bam-project/esp32-sobel-camera/cad/portable-camera.FCStd

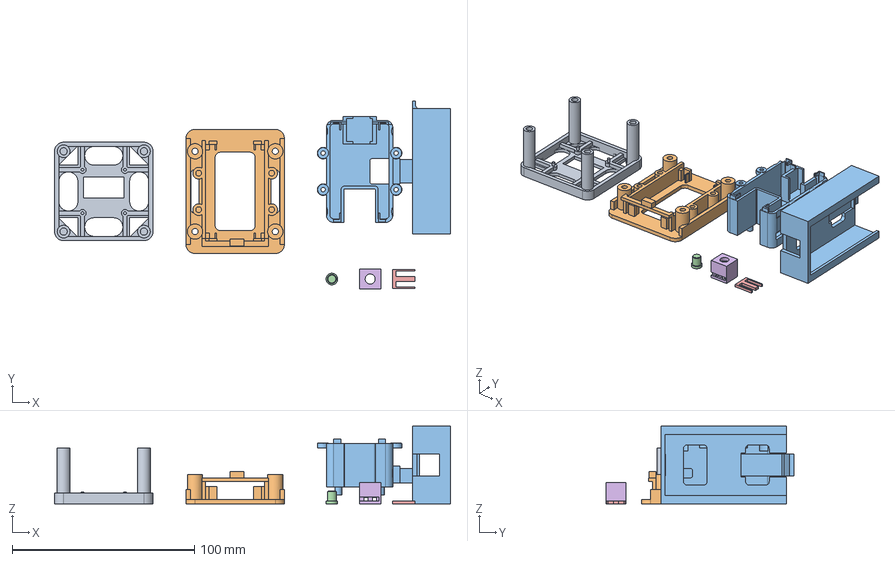
[picture p5: CAD file, 2026-10-13]
cad/portable-camera.FCStd
217.0 x 102.9 x 42.6 mm
01 — Screen body
02 — Camera base
03 — Cable cover
04 — Shutter press cap
06 - Sliding shutter backing key
05 - Removable shutter tray
