bam-project/esp32-sobel-camera/printing/parts/04-shutter-cap.3mf

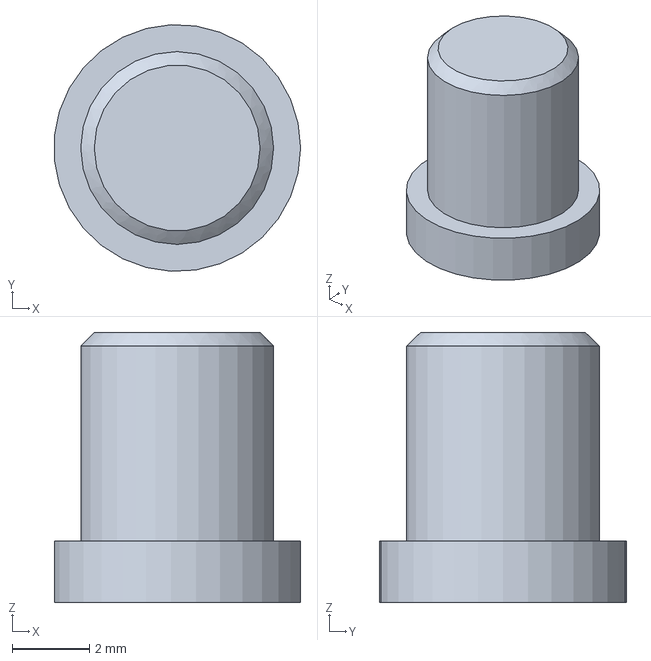
[picture p6: CAD file, 2026-10-13]
printing/parts/04-shutter-cap.3mf
6.38 x 6.39 x 7.00 mm
