bam-project/esp32-sobel-camera/printing/parts/02-camera-base.3mf

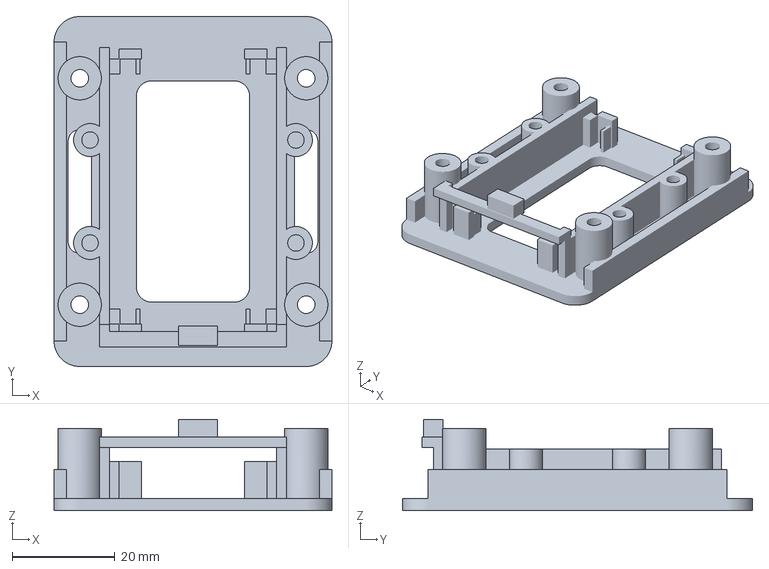
[picture p7: CAD file, 2026-10-13]
printing/parts/02-camera-base.3mf
54.0 x 68.0 x 17.8 mm
