bam-project/esp32-sobel-camera/printing/parts/01-screen-body.3mf

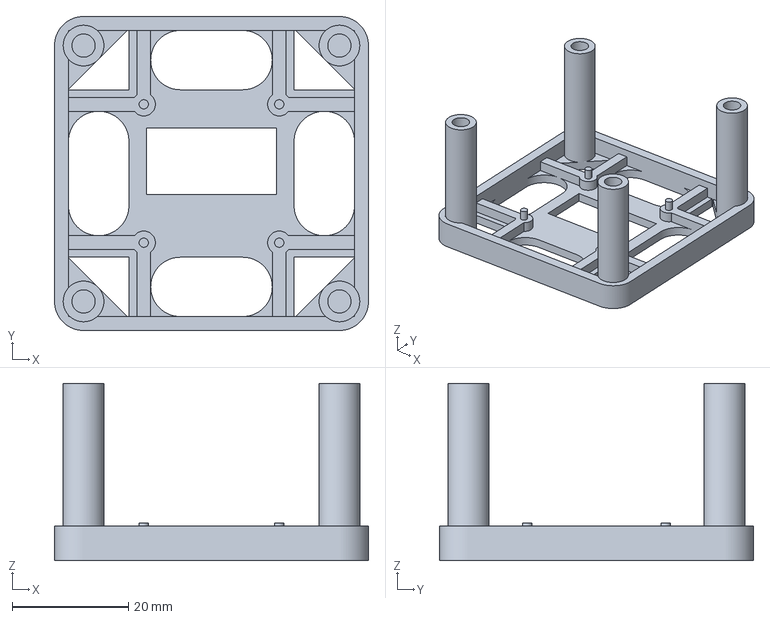
[picture p8: CAD file, 2026-10-13]
printing/parts/01-screen-body.3mf
54.0 x 54.0 x 30.5 mm
