bam-project/esp32-sobel-camera/printing/parts/05-shutter-tray.3mf

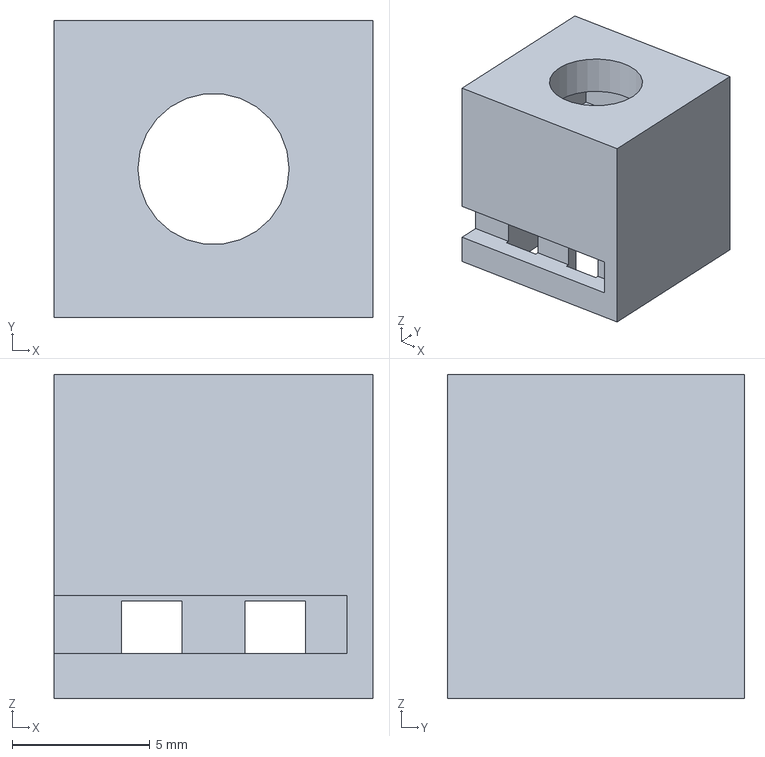
[picture p9: CAD file, 2026-10-13]
printing/parts/05-shutter-tray.3mf
11.6 x 10.8 x 11.8 mm
