bam-project/esp32-sobel-camera/printing/parts/03-cable-cover.3mf

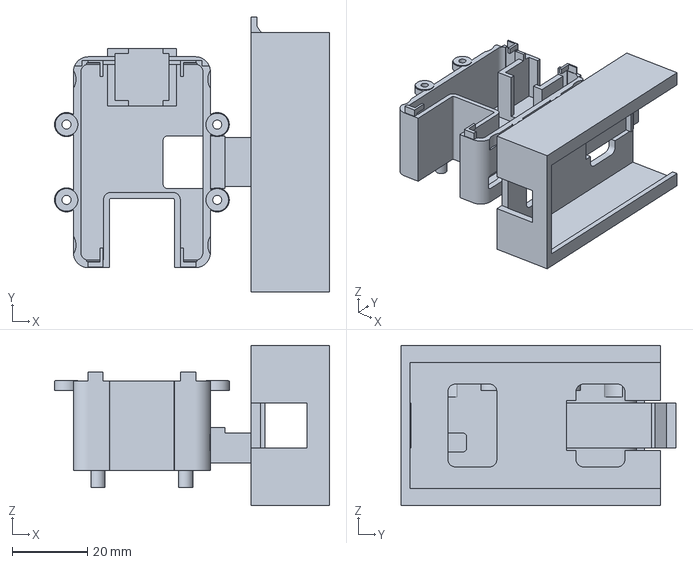
[picture p10: CAD file, 2026-10-13]
printing/parts/03-cable-cover.3mf
73.0 x 72.9 x 42.6 mm
