bam-project/esp32-sobel-camera/printing/parts/06-shutter-backing-key.3mf

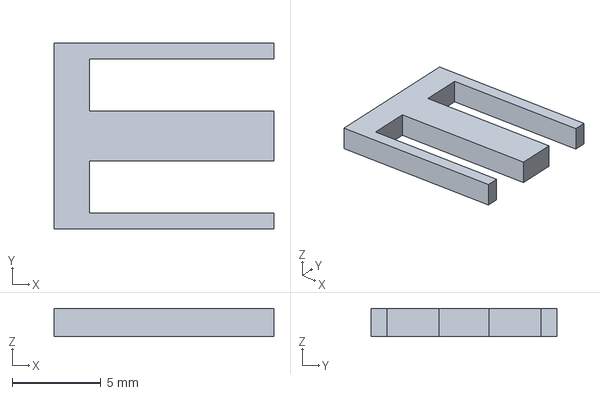
[picture p11: CAD file, 2026-10-13]
printing/parts/06-shutter-backing-key.3mf
12.4 x 10.5 x 1.60 mm
